nicolas-takimo/TCC-Controle-de-acesso-remoto-usando-Digiprox-S--202/pre-textuais/figuras/ESP8266.JPG

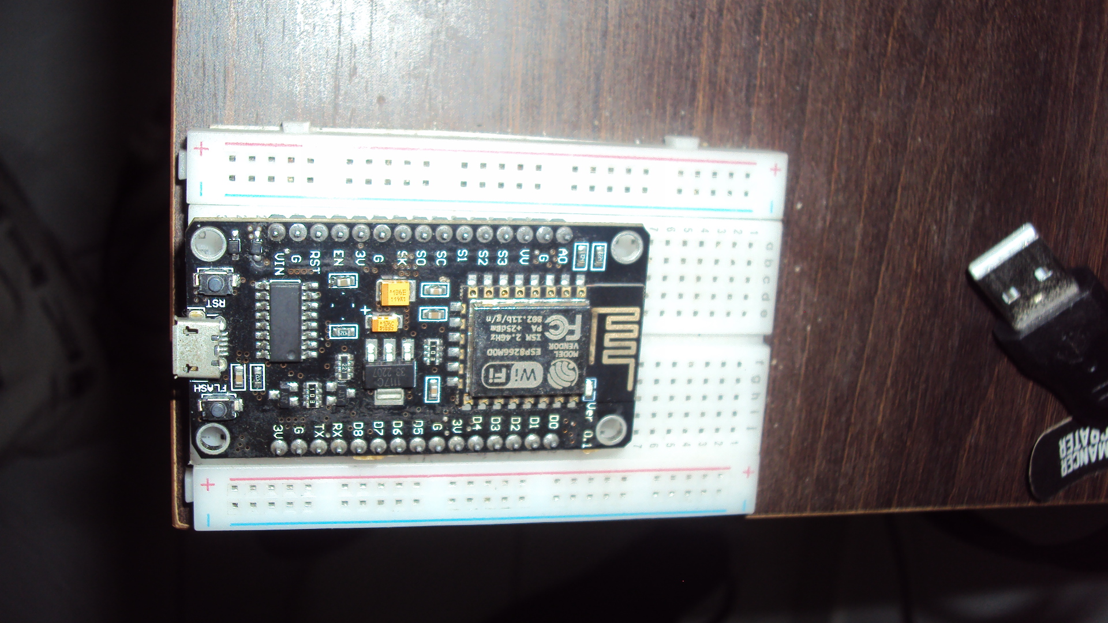
pre-textuais/figuras/ESP8266.JPG
