nicolas-takimo/TCC-Controle-de-acesso-remoto-usando-Digiprox-S--202/pre-textuais/catalograficos.tex

%
% ********** Ficha Catalográfica
%

\newpage

\begin{center}

% Aqui não se usou \vfill porque o \vfill é construído internamente com
% o comando \vspace. Espaços verticais no início da folha com \vspace
% são ignorados. Para que isto não ocorra deve-se usar o \vspace*
% \vspace*{\fill} é como se fosse um \vfill*
\vspace*{\fill}

%Divisão de Serviços Técnicos\\[1ex]
Catalogação da publicação na fonte.
UFMT / Biblioteca Central

Obter a Ficha pelo site \url{https://academico-siga.ufmt.br/ufmt.sfc/Home/Ficha}, gerar o arquivo PDF (para manter a qualidade) e inserir nesta posição.

\end{center}
