nicolas-takimo/TCC-Controle-de-acesso-remoto-usando-Digiprox-S--202/pre-textuais/preambulo.tex

%
% ********** Dedicatória
%

% A dedicatória não é obrigatória. Se você tem alguém ou algo que teve
% uma importância fundamental ao longo do seu curso, pode dedicar a ele(a)
% este trabalho. Geralmente não se faz dedicatória a várias pessoas: para
% isso existe a seção de agradecimentos.
% Se não quiser dedicatória, basta excluir o texto entre
% \begin{titlepage} e \end{titlepage}

\begin{titlepage}

\vspace*{\fill}

\hfill
\begin{minipage}{0.5\linewidth}
\begin{flushright}
\large\it
Aos meus amigos do serviço e a minha namorada por me dar forças para realizar o trabalho.
\end{flushright}
\end{minipage}

\vspace*{\fill}

\end{titlepage}

%
% ********** Agradecimentos
%

% Os agradecimentos não são obrigatórios. Se existem pessoas que lhe
% ajudaram ao longo do seu curso, pode incluir um agradecimento.
% Se não quiser agradecimentos, basta excluir o texto após \chapter*{...}

\chapter*{Agradecimentos}
\thispagestyle{empty}

\begin{trivlist}  \itemsep 2ex

\item Ao meu orientador, Prof. Dr. Fabrício Carvalho, por fornecer o tema deste trabalho, pela aquisição da controladora SA-202 que tornou possível a realização dos experimentos, e pela orientação dedicada ao longo de todo o projeto.

\item Aos meus amigos de trabalho, pela valiosa ideia da conexão da antena em paralelo, que se mostrou fundamental para o sucesso da solução desenvolvida.

\item À minha namorada, pelo apoio incondicional e pela motivação constante durante toda esta jornada acadêmica.

\item Aos meus pais, por todo o apoio financeiro e emocional que me permitiu concluir a faculdade e chegar até este momento.

\item À UFMT, pela oportunidade de cursar Engenharia de Computação e pela infraestrutura disponibilizada.

\end{trivlist}
