nicolas-takimo/TCC-Controle-de-acesso-remoto-usando-Digiprox-S--202/textuais/apendice/apendice.tex

%%
%% Apêndice
%%

\mychapter{Informações Complementares}
\label{Cap:apendice}

\section{Declaração do Orientador Para a Biblioteca}

Eu,  \textit{Prof. Dr. Fabrício Carvalho},  na  qualidade  de orientador(a) do aluno (a) \textit{Nícolas Gabriel Meneses De Jesus} do Curso de Engenharia de Computação  declaro  para  os  devidos  fins  que  o  trabalho  intitulado \textbf{Sistema de Controle de Acesso com RFID Integrado ao Firebase: Uma Abordagem de Interceptação Paralela para Modernização de Sistemas Legados} RESPEITA TODOS  OS  DIREITOS  AUTORAIS,  estando  isento  de  plágio,  cópias  ilegais  ou quaisquer ofensas aos direitos de outros autores, em conformidade com o que rege a Lei nº 9.610/98. Declaro, ainda, que o trabalho em questão passou por uma banca de  avaliação,  sendo  realizadas  as  devidas  correções  e,  estando  assim,  apto  a  ser disponibilizado em texto integral, na Biblioteca Digital da UFMT ou em qualquer outro sistema de automação e gestão de acervos, utilizado pela Instituição, para consulta e acesso livre de modo on-line.
