nicolas-takimo/TCC-Controle-de-acesso-remoto-usando-Digiprox-S--202/pre-textuais/figuras/ufmt.pdf

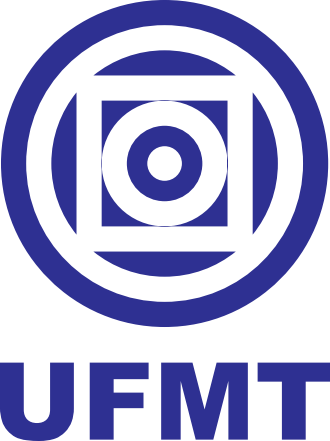
[picture p3: figure]
