nicolas-takimo/TCC-Controle-de-acesso-remoto-usando-Digiprox-S--202/pre-textuais/figuras/antenaRdm6300.JPG

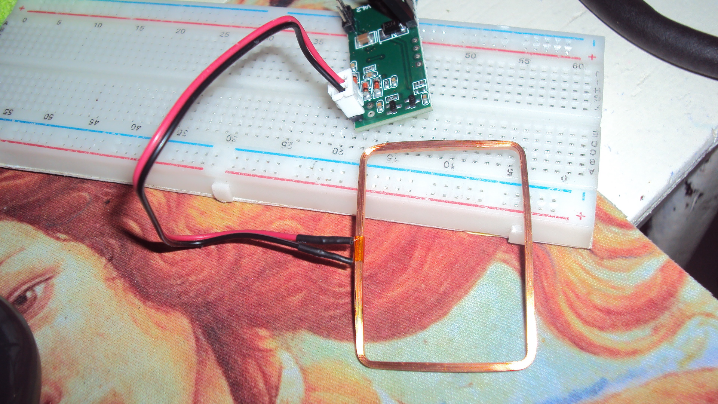
pre-textuais/figuras/antenaRdm6300.JPG
