nicolas-takimo/TCC-Controle-de-acesso-remoto-usando-Digiprox-S--202/pre-textuais/figuras/cartoesRFID.JPG

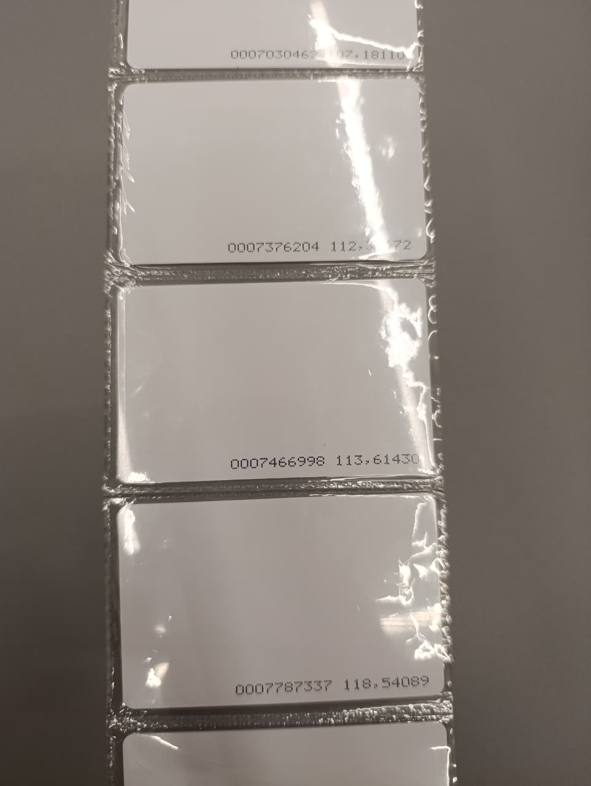
pre-textuais/figuras/cartoesRFID.JPG
