nicolas-takimo/TCC-Controle-de-acesso-remoto-usando-Digiprox-S--202/pre-textuais/figuras/DigiproxSa202Frente.JPG

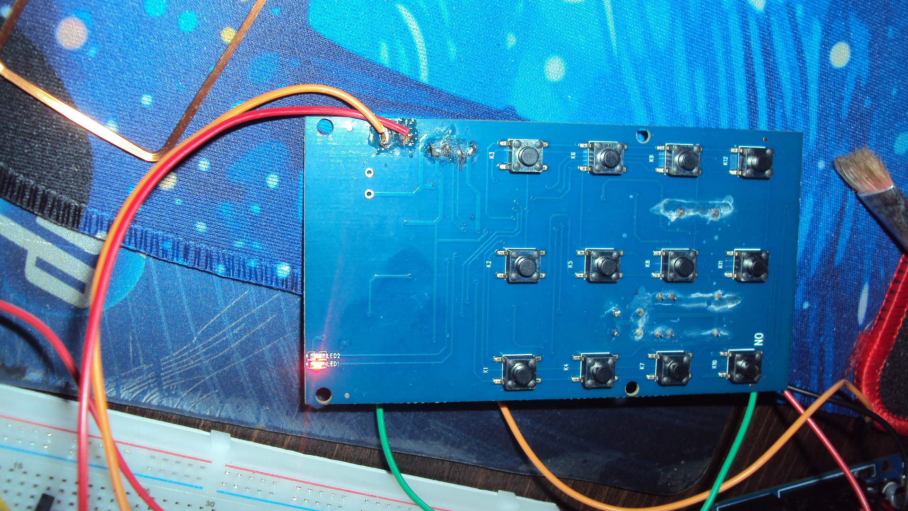
pre-textuais/figuras/DigiproxSa202Frente.JPG
