nicolas-takimo/TCC-Controle-de-acesso-remoto-usando-Digiprox-S--202/pre-textuais/figuras/DSC08733.JPG

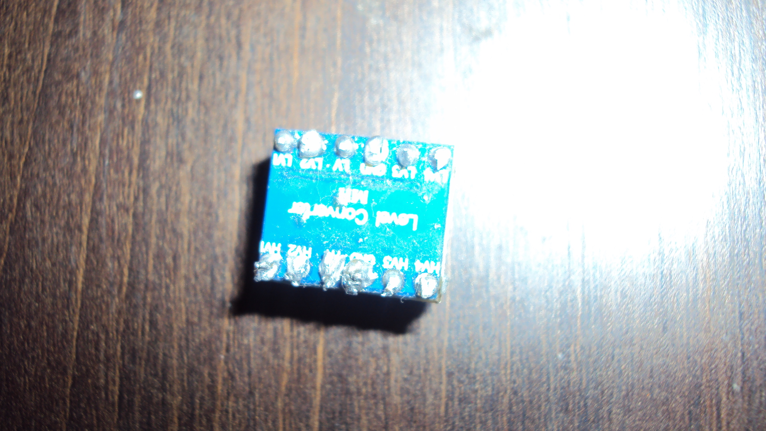
pre-textuais/figuras/DSC08733.JPG
