nicolas-takimo/TCC-Controle-de-acesso-remoto-usando-Digiprox-S--202/pre-textuais/figuras/EsquemaArduinoESp.jpg

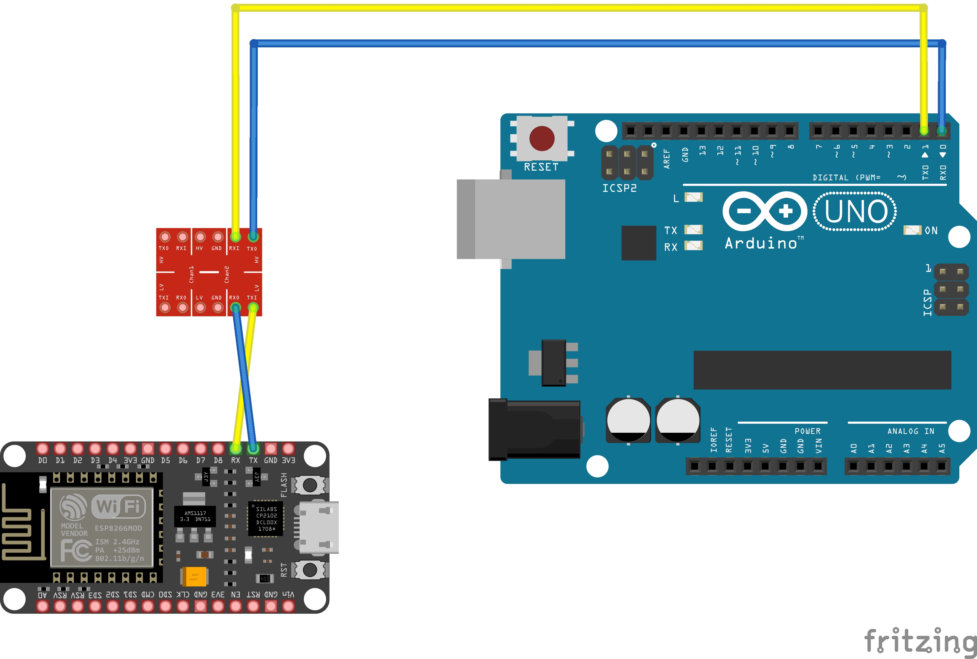
pre-textuais/figuras/EsquemaArduinoESp.jpg
