nicolas-takimo/TCC-Controle-de-acesso-remoto-usando-Digiprox-S--202/pre-textuais/figuras/EsquemadeLigaçãoRDMSA202.JPG

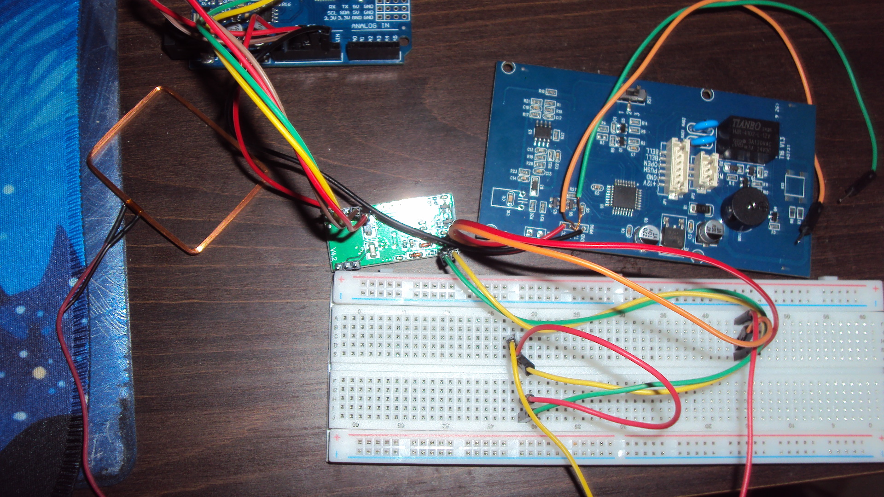
pre-textuais/figuras/EsquemadeLigaçãoRDMSA202.JPG
