nicolas-takimo/TCC-Controle-de-acesso-remoto-usando-Digiprox-S--202/pre-textuais/figuras/esquemaEmparalelo.jpg

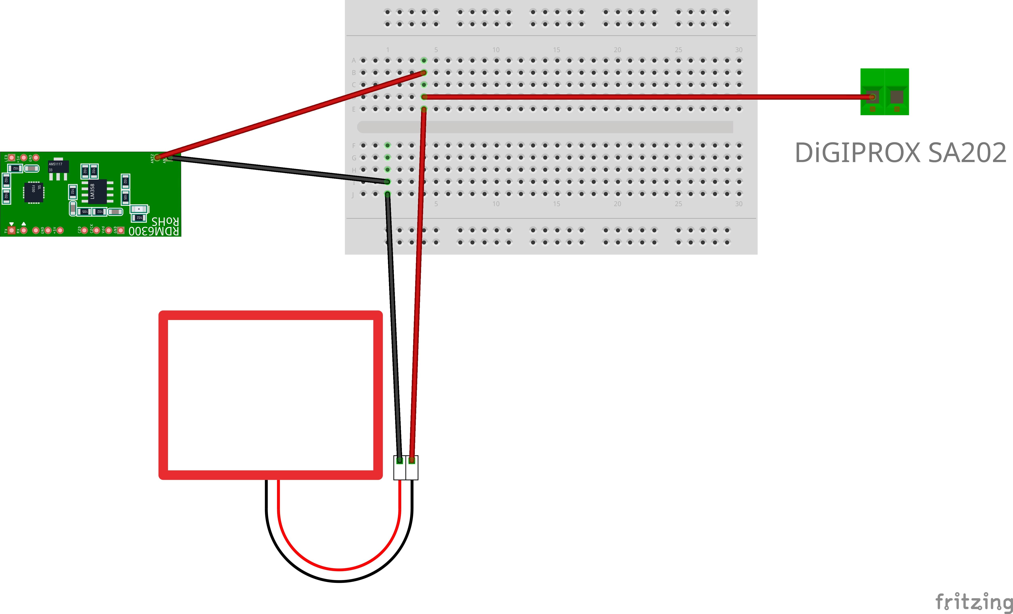
pre-textuais/figuras/esquemaEmparalelo.jpg
