nicolas-takimo/TCC-Controle-de-acesso-remoto-usando-Digiprox-S--202/pre-textuais/figuras/Levelconverter MH.png

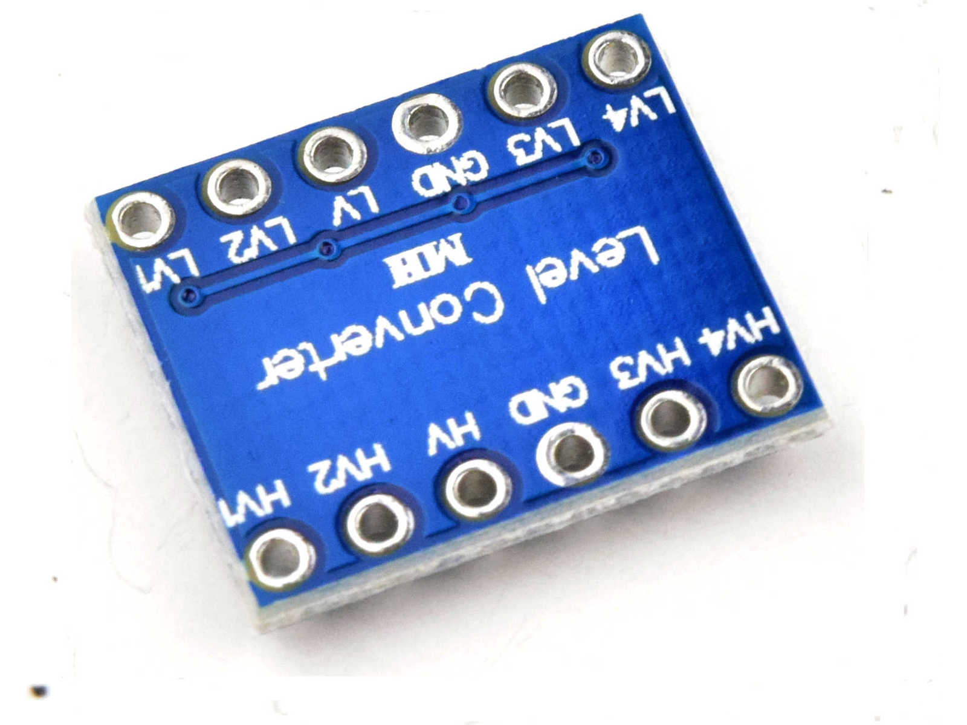
pre-textuais/figuras/Levelconverter MH.png
