nicolas-takimo/TCC-Controle-de-acesso-remoto-usando-Digiprox-S--202/pre-textuais/figuras/pinagem_stc8c2k..png

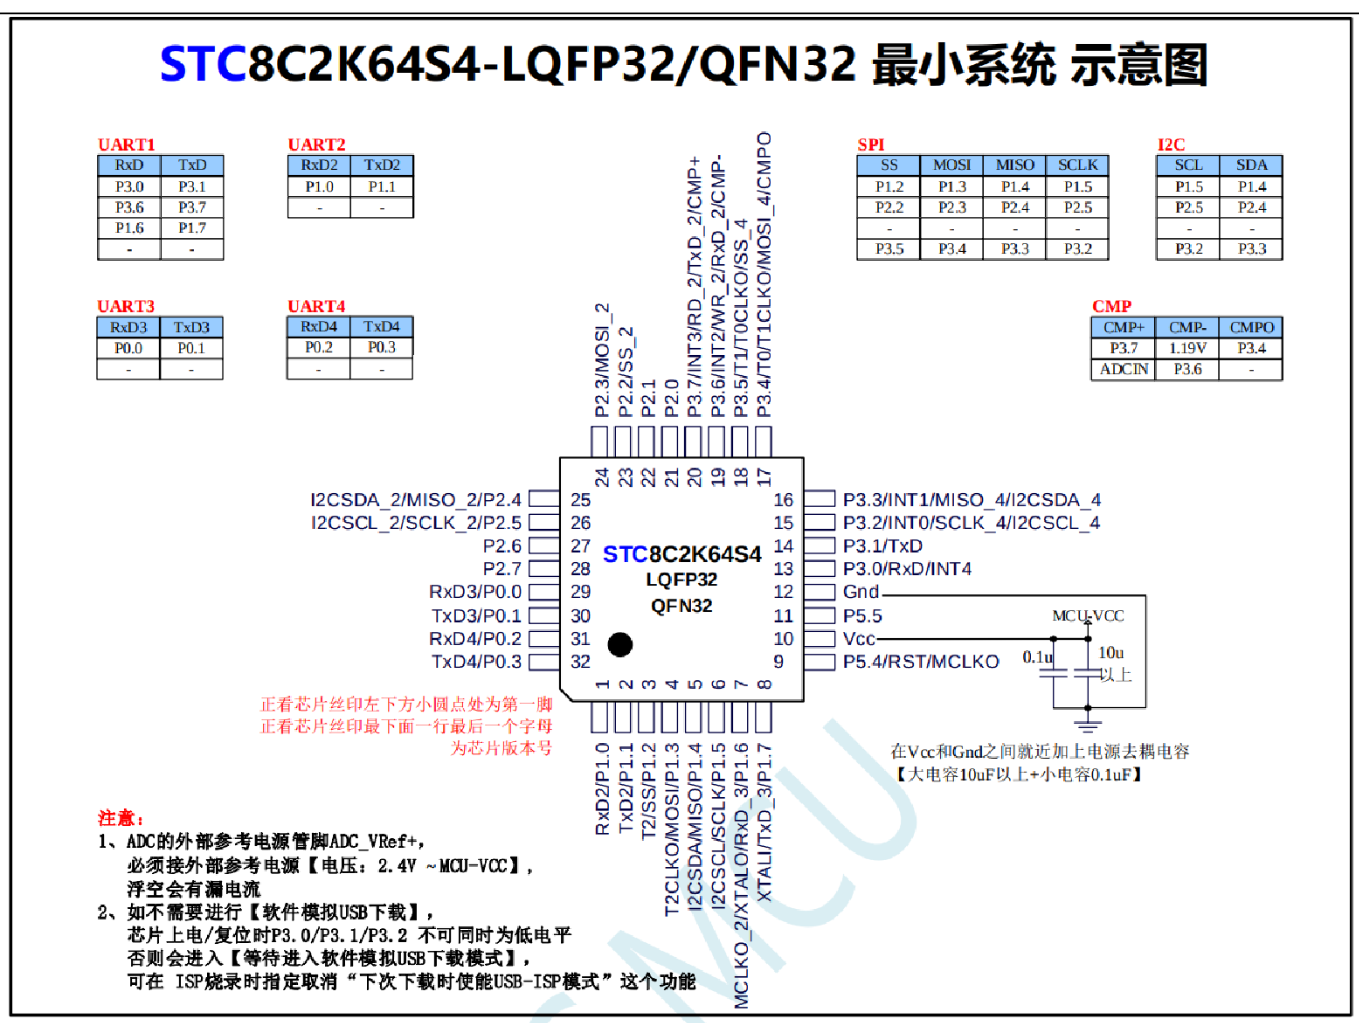
pre-textuais/figuras/pinagem_stc8c2k..png
