nicolas-takimo/TCC-Controle-de-acesso-remoto-usando-Digiprox-S--202/pre-textuais/figuras/RDM6300PNG.png

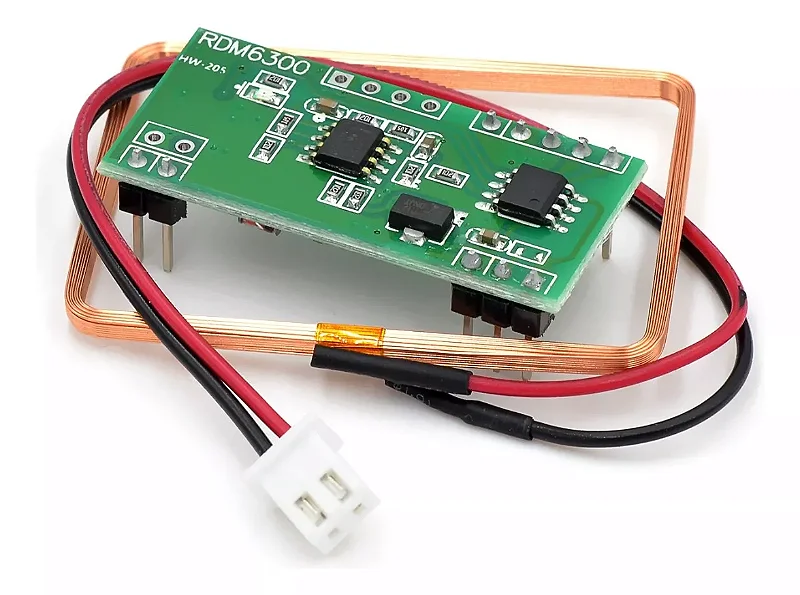
pre-textuais/figuras/RDM6300PNG.png
