nicolas-takimo/TCC-Controle-de-acesso-remoto-usando-Digiprox-S--202/pre-textuais/figuras/RDm e Arduino UNO.JPG

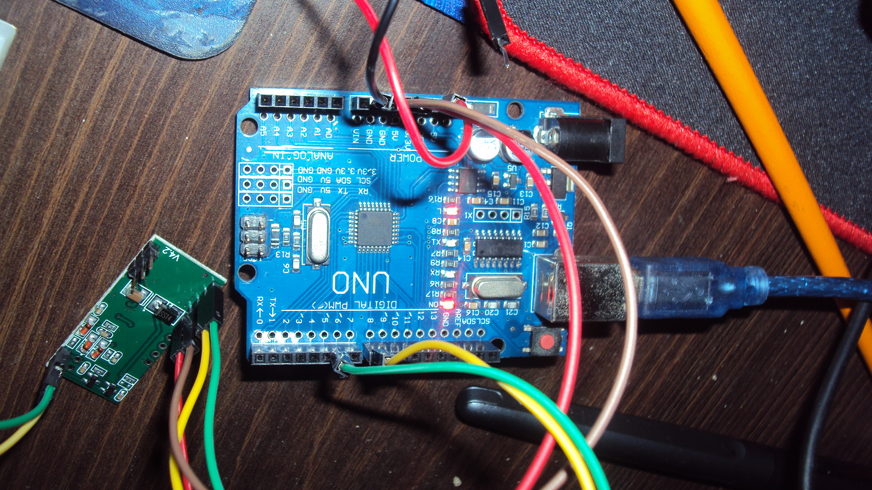
pre-textuais/figuras/RDm e Arduino UNO.JPG
