nicolas-takimo/TCC-Controle-de-acesso-remoto-usando-Digiprox-S--202/pre-textuais/figuras/RdmcomArduino.png

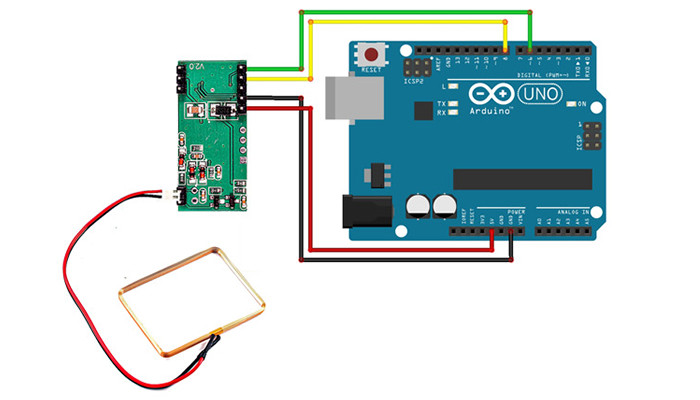
pre-textuais/figuras/RdmcomArduino.png
